wagiminator/ATtiny814-Power-Analyzer/hardware/PowerAnalyzer_BOM_v1.0.tsv

ID | Name | Designator | Footprint | Quantity | Manufacturer Part | Manufacturer | Supplier | Supplier Part | LCSC Assembly
1 | LMV321 | U3 | SOT-23-5_L3.0-W1.7-P0.95-LS2.8-BL | 1 | LMV321B-TR | 3PEAK | LCSC | C248567 | Yes
2 | CH330N | U2 | SOP-8_150MIL | 1 | CH330N | WCH | LCSC | C108996
3 | 1N4148W | D2 | DIODE-SOD-123 | 1 | 1N4148W-E3-08 | Vishay Intertech | LCSC | C241939
4 | SI2302 | Q2 | SOT-23_L2.9-W1.3-P0.95-LS2.4-BR | 1 | SI2302 | Bourne Semicon (Shenzhen) | LCSC | C344009 | Yes
5 | KF301-2P | PWR-OUT,PWR-IN,TEST-IN | KF301-2P | 3 | KF301R-5.0-2P | Cixi Kefa Elec | LCSC | C474883
6 | USB-B-Female | USB | USB-M-49 | 1 | USB-B-Female-90-TH |  | LCSC | C46393
7 | 1k | R5,R6,R3,R2,R13,R4 | 0603 | 6 | 0603WAF1001T5E | UniOhm | LCSC | C21190
8 | 10k | R10,R14,R15 | 0603 | 3 | 0603WAF1002T5E | UniOhm | LCSC | C25804
9 | 1k5 | R16 | 0603 | 1 | 0603WAF1501T5E | UniOhm | LCSC | C22843
10 | 4k7 | R12,R1,R11 | 0603 | 3 | 0603WAF4701T5E | UniOhm | LCSC | C23162
11 | Header | UPDI | HDR-3X1/2.54 | 1 | Header2.54mm 1*3P | BOOMELE | LCSC | C49257
12 | IRL540NPBF | Q1 | TO-220-3_L10.0-W4.5-P2.54-T | 1 | IRL540NPBF | Infineon | LCSC | C111607
13 | ATTINY814-SSN | U1 | SOIC-14_150MIL | 1 | ATTINY814-SSNR | Microchip Tech | LCSC | C182202 | Yes
14 | 1u | C5 | 0603 | 1 | CL10A105KB8NNNC | SAMSUNG | LCSC | C15849
15 | INA219 | U5,U4 | SOT-23-8_L3.0-W1.7-P0.65-LS2.8-BL | 2 | INA219AIDCNR | TI | LCSC | C87469 | Yes
16 | Header | EXPANSION,I2C | HDR-4X1/2.54 | 2 | 220S-1*4P H=8.5MM Ytype Gold-plated | Ckmtw | LCSC | C124413
17 | 100n | C4,C3,C9,C1,C10,C8,C6,C7 | 0603 | 8 | CC0603KRX7R9BB104 | YAGEO | LCSC | C14663
18 | 47u | C2 | 1206 | 1 | 1206F476M160NT | FH | LCSC | C30300
19 | LED | RDY,PWR,BUSY | LED-0603 | 3 | 19-217/BHC-ZL1M2RY/3T | EVERLIGHT | LCSC | C72041
20 | Header | NTC,FAN | HEADER_2X1 | 2 | 826629-2 | TE Connectivity | LCSC | C86471
21 | R300 | R7,R8,R9 | 2512 | 3 | CR2512F0R3E04 | Ever Ohms Tech | LCSC | C176052
22 | R008 | R17,R18 | 2512 | 2 | MRF6432(2512)LR008FTS | SUP | LCSC | C76241
23 | SS54 | D1 | DIODE-SMA(DO-214AC) | 1 | SS54 | Jingdao | LCSC | C123946 | Yes
