wagiminator/ATtiny814-Power-Analyzer/(threads)

Thread 1 (2022-10-07):

Question about 25W Limit

davrad3, 2022-10-07:
Hi, why is there a 25W Limit for this circuit ?
Thanks in advance for your response.

wagiminator, 2022-10-07:
Hi, there is no limit for the circuit per se, but you can set one in the firmware parameters according to the capabilities of your cooling solution (for me it's 25W but it can be way higher with a better heatsink).
