wagiminator/ATtiny814-Power-Analyzer/hardware/PowerAnalyzer_schematic_v1.0.pdf

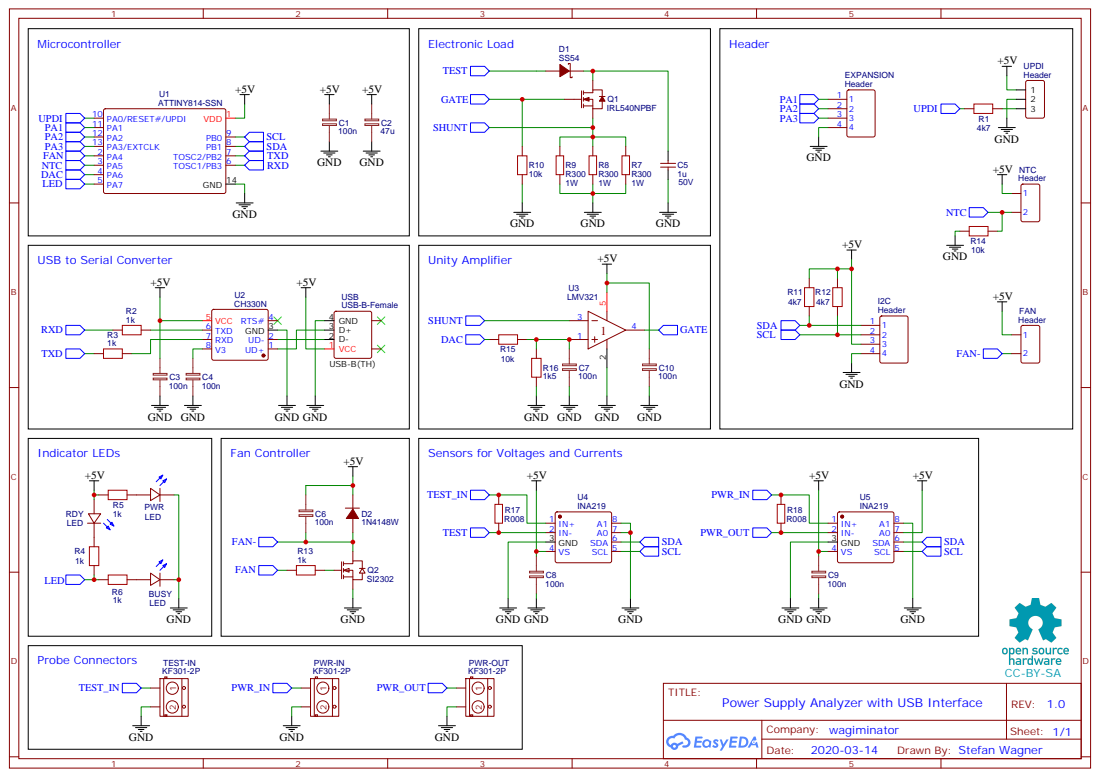
[picture p14: page 1]

USB to Serial Converter

Sensors for Voltages and Currents

Drawn By: Stefan Wagner
